icprog/FaboolCo2Pcba/README.md

# Fabool Laser CO2 PCBA
- Product page: https://www.smartdiys.cc/fabool-laser-co2/
- Shop page: https://shop.smartdiys.cc/collections/co2-laser-cutter-and-engraver
- Manual page: https://www.smartdiys.cc/manual/fabool-laser-co2-2/
