icprog/FaboolCo2Pcba/LaserCo2Board BOM_20170105.xlsx

Part / Value | Package | Manufacturer | Part No | Circuit Reference | Qty | URL
LD1117 | SOT-223 | STMicroelectronics | LD1117S33TR | U4 | 1 | http://www.digikey.jp/product-detail/ja/stmicroelectronics/LD1117S33TR/497-1242-2-ND/585766
74HC08A | TSSOP-14 | ON Semiconductor | MC74HC08ADTR2G | U5 | 1 | http://www.digikey.jp/product-detail/ja/on-semiconductor/MC74HC08ADTR2G/MC74HC08ADTR2GOSTR-ND/919179
74HC1G00 | TSOP-5 | ON Semiconductor | MC74HC1G00DTT1G | U8 | 1 | http://www.digikey.jp/product-detail/ja/MC74HC1G00DTT1G/MC74HC1G00DTT1GOSCT-ND/1967104
A4982 | 24-TSSOP | Allegro MicroSystems, LLC | A4982SLPTR | U3,U2 | 2 | http://www.digikey.jp/product-detail/ja/allegro-microsystems-llc/A4982SLPTR-T/620-1352-2-ND/2295512
MCP4461 | 20-TSSOP | Microchip Technology | MCP4461-103E/ST | U7 | 1 | http://www.digikey.jp/product-detail/ja/microchip-technology/MCP4461-103E%2FST/MCP4461-103E%2FST-ND/2486262
MCP4725 | SOT-23-6 | Microchip Technology | MCP4725A0T-E/CH | U6 | 1 | http://www.digikey.jp/product-detail/ja/microchip-technology/MCP4725A0T-E-CH/MCP4725A0T-E-CHTR-ND/1818537
STM32F205 | 64-LQFP | STMicroelectronics | STM32F205RBT6 | U1 | 1 | http://www.digikey.jp/product-search/ja?keywords=STM32F205RBT6
BSH105,215 | SOT-23 | NXP Semiconductors | BSH105 | TR1 | 1 | http://www.digikey.jp/product-detail/ja/nxp-semiconductors/BSH105,215/568-6215-2-ND/1155056
BSS138 | SOT-23 | Fairchild Semiconductor | BSS138 | Q1,Q2 | 2 | http://www.digikey.jp/product-detail/ja/fairchild-semiconductor/BSS138/BSS138CT-ND/244294
Tact Switch | DHT-1163S | D.O Electronics Co.,Ltd | DHT-1163S | SW1 | 1 | http://www.seeedstudio.com/depot/images/opl/datasheet/311020029.pdf
DIP Switch | MS-22D18 | DG De Yi Long Electronics Hardware Limited | MS-22D18 G2 | SW2 | 1 | http://www.seeedstudio.com/depot/images/opl/datasheet/3010010P1.pdf
ESD
VARISTOR 0603 | 0603 | Bourns Inc. | CG0603MLC-05E | VR1,VR2 | 2 | http://www.digikey.jp/product-detail/ja/bourns-inc/CG0603MLC-05E/CG0603MLC-05ETR-ND/2538084
Ferrite bead
220Ω@100MHz, 700mA | 0603 | Laird-Signal Integrity Products | LI0603G221R-10 | L1 | 1 | http://www.digikey.jp/product-detail/ja/LI0603G221R-10/240-2368-1-ND/806728
220Ω@100MHz, 2A | 0805 | Murata Electronics North America | BLM21PG221SN1D | L2 | 1 | http://www.digikey.jp/product-detail/ja/murata-electronics-north-america/BLM21PG221SN1D/490-1054-2-ND/364909
30Ω@100MHz, 8.5A | 0805 | Murata Electronics North America | BLM21SN300SN1D | L3,L4 | 2 | http://www.digikey.jp/product-detail/ja/murata-electronics-north-america/BLM21SN300SN1D/490-13266-6-ND/5881281
Crystal
25MHz, 18pF | 5032 | TXC CORPORATION | 7B-25.000MAAJ-T | X1 | 1 | http://www.digikey.jp/product-detail/ja/txc-corporation/7B-25.000MAAJ-T/887-1112-2-ND/2118796
RTC Crystal
32.768KHz, 7pF | 2-SMD | TXC CORPORATION | 9HT10-32.768KDZY-T | X2 | 1 | http://www.digikey.jp/product-detail/ja/txc-corporation/9HT10-32.768KDZY-T/887-1506-2-ND/2690359
LED
2V, 3mA, Red | 0805 | Any | Any | D1,D2,D3,D4,D5,D8 | 6
2V, 3mA, Green | 0805 | Any | Any | D7 | 1
2V, 3mA, Blue | 0805 | Any | Any | D6 | 1
Ceramic Capacitor
10p, Ceramic, 10V, 10% | 0603 | Any | Any | C24,C30 | 2
20p, Ceramic, 10V, 10% | 0603 | Any | Any | C19,C22 | 2
0u1, Ceramic, 10V, 10% | 0603 | Any | Any | C11,C12,C13,C14,C17,C18,C20,C21,C26,C27,C28,C29,C31,C33,C36,C38,C40 | 17
0u22, Ceramic, 10, 10% | 0603 | Any | Any | C1,C2,C9,C10 | 4
2u2, Ceramic, 10V, 10% | 0603 | Any | Any | C15,C16 | 2
1u, Ceramic, 10V, 10% | 0603 | Any | Any | C35 | 1
0u1, Ceramic, 16V, 10% | 0805 | Any | Any | C3,C4,C7,C8,C23 | 5
10u, Ceramic, 10V, 10% | 0805 | Any | Any | C32,C34,C37 | 3
Tantalum Capacitor
10uF, 10V, 20% | 1206 | Any | Any | C25 | 1
Aluminum Capacitor
100u, 35V, 20% | 6.3 x 7.7mm | Any | Any | C5,C6,C39 | 3 | http://www.digikey.jp/product-detail/ja/UWT1V101MCL1GS/493-2203-1-ND/590178
Resistor
0R, 1/10W | 0603 | Any | Any | R6,R7 | 2
22R, 1/10W, 5% | 0603 | Any | Any | R27, R39,R40 | 3
47R, 1/10W, 5% | 0603 | Any | Any | R34 | 1
100R, 1/10W, 5% | 0603 | Any | Any | R41 | 1
390R, 1/10W, 5% | 0603 | Any | Any | R36 | 1
470R, 1/10W, 5% | 0603 | Any | Any | R16,R17,R18,R25,R26,R45 | 6
1k5, 1/10W, 5% | 0603 | Any | Any | R44 | 1
2k7, 1/10W, 5% | 0603 | Any | Any | R32 | 1
4k7, 1/10W, 5% | 0603 | Any | Any | R28,R31,R43 | 3
10k, 1/10W, 5% | 0603 | Any | Any | R1,R3,R5,R12,R13,R14,R15,R19,R20,R21,R22,R23,R24,R29,R30,R37,R38,R42 | 18
100k, 1/10W, 5% | 0603 | Any | Any | R2,R4 | 2
0R1, 1W, 5% | 1206 | Any | Any | R8,R9,R10,R11 | 4
1k5, 1/2W, 5% | 1206 | Any | Any | R35 | 1
Connector
USB Type B Connector | USB - B | Any | Any | J4 | 1 | http://www.digikey.jp/product-detail/ja/on-shore-technology-inc/USB-B1HSW6/ED2982-ND/2677743
2P Connector |  | JST Sales America Inc | B2B-XH-A(LF)(SN) | J5,J6,J7,J8,J9,J15,J16,J17,J18,J19,J20 | 11
3P Connector |  | JST Sales America Inc | B3B-XH-A(LF)(SN) | J10,J13 | 2
4P Connector |  | JST Sales America Inc | B4B-XH-A(LF)(SN) | J11,J12,J14 | 3
Other
Heat Sink |  | Shenzhen S-mart Electronics Co.,Ltd | Heatsink 8.8*8.8*5mm with 3m thermal conductivity double-sided tape |  | 2
