icprog/FaboolCo2Pcba/LaserCo2Board/LaserCo2Board.pdf

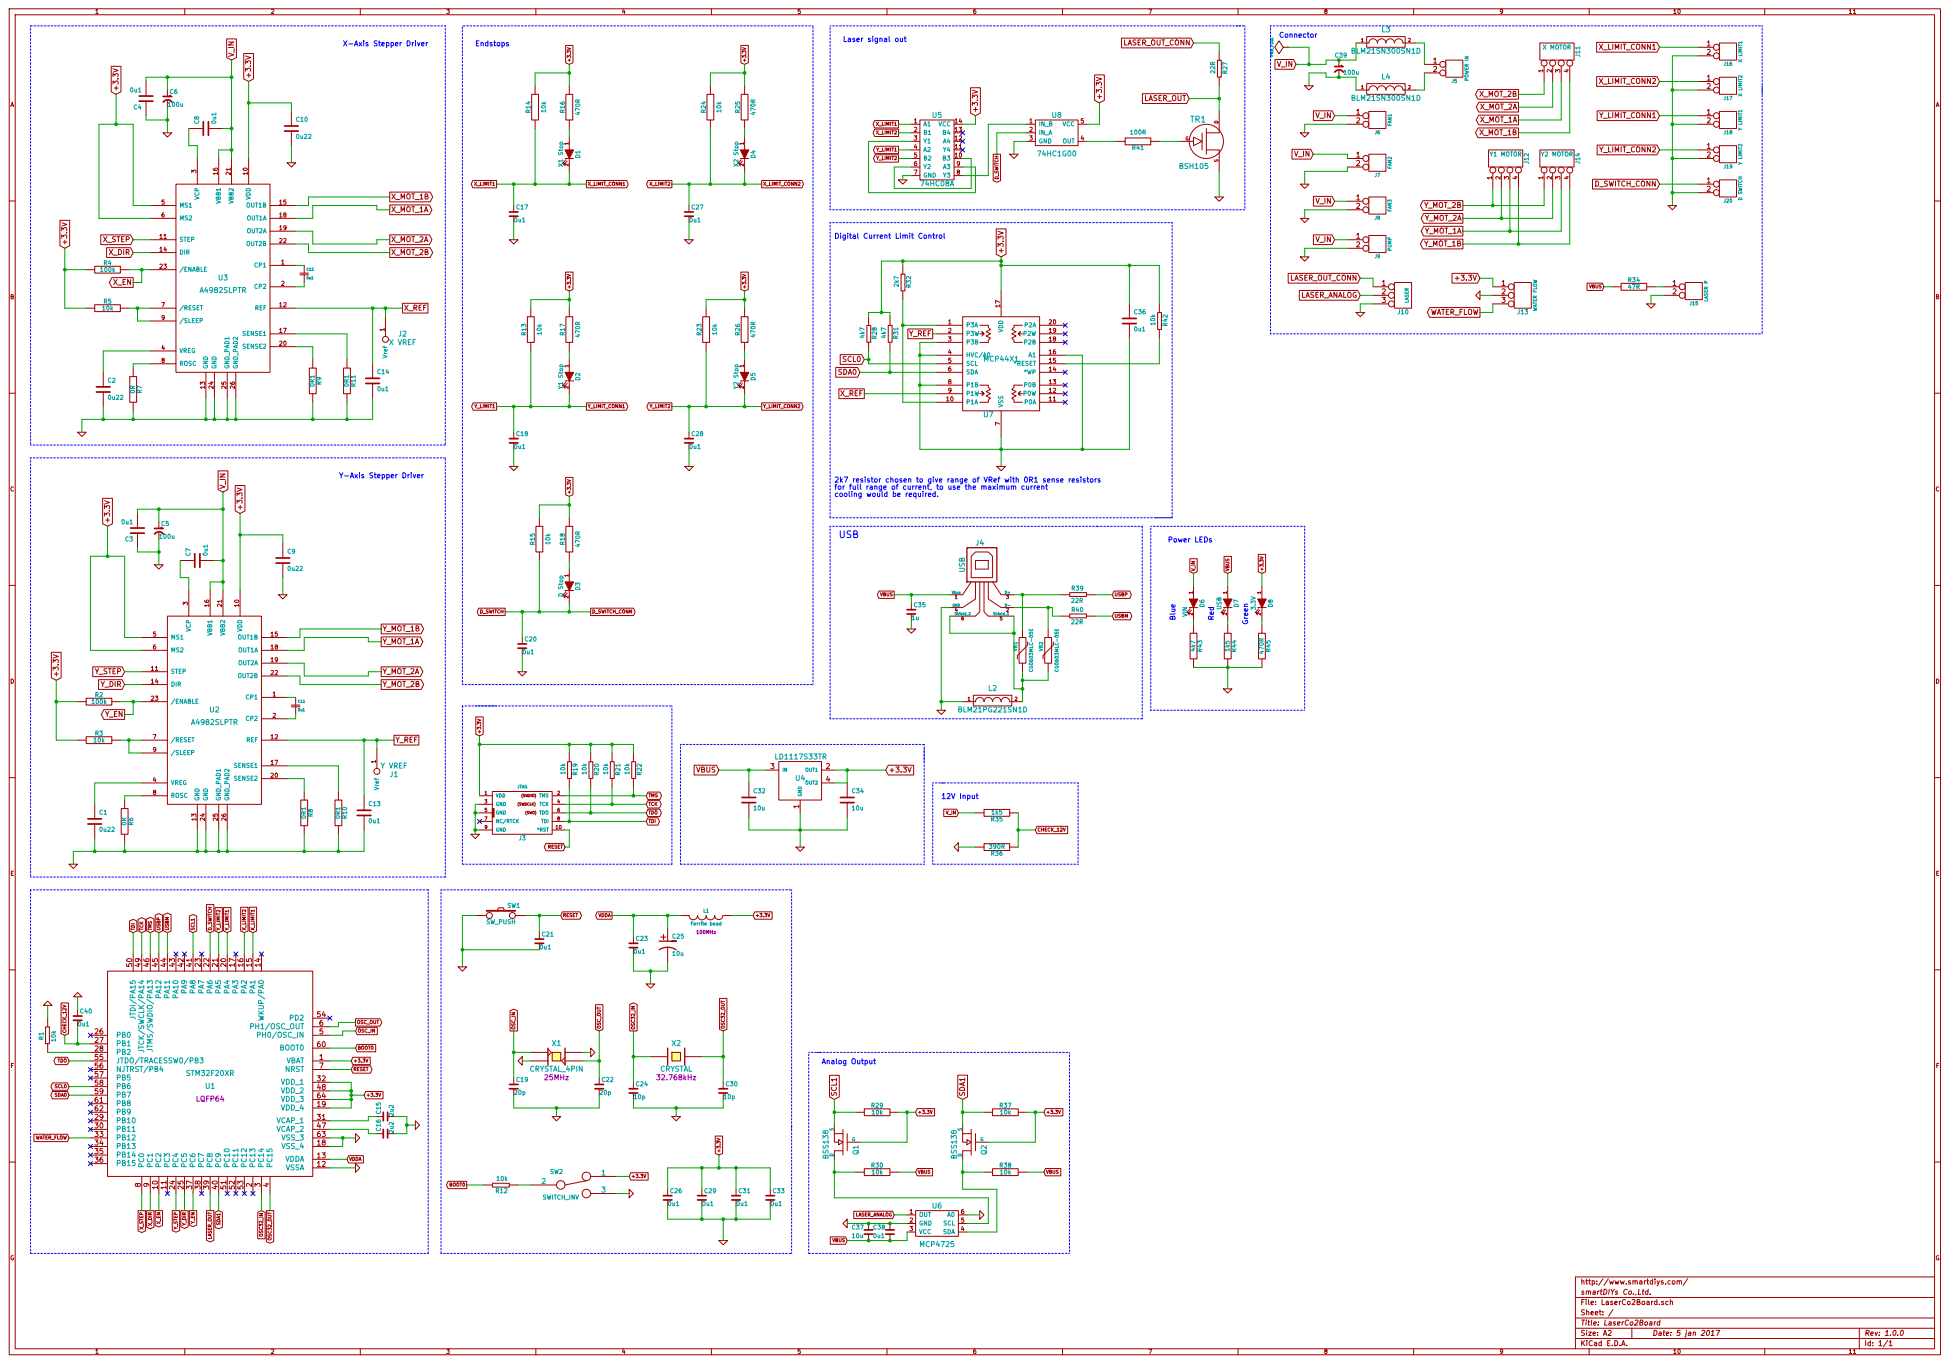
[picture p1: page 1]

Digital Current Limit Control

for full range of current, to use the maximum current

1 2 D6 VIN Power LEDs V_IN +3.3V Blue Green

USBP USBM TCK TMS USBP USBM
