icprog/FaboolCo2Pcba/LaserCo2Board/LaserCo2Board.kicad_pcb

## KiCad design LaserCo2Board/LaserCo2Board.kicad_pcb (2018-01-18)

Schematic: LaserCo2Board.sch

Parts:
C1, C2, C9, C10: 0u22
C3, C4, C7, C8, C11, C12, C13, C14, C17, C18, C20, C21, C23, C26, C27, C28, C29, C31, C33, C36, C38, C40: 0u1
C5, C6, C39: 100u
C15, C16: 2u2
C19, C22: 20p
C24, C30: 10p
C25: 10u
C32, C34, C37: 10u
C35: 1u
D1: X1 Stop
D2: Y1 Stop
D3: D Stop
D4: X2 Stop
D5: Y2 Stop
D6: VIN
D7: USB
D8: 3.3V
J1: Y VREF
J2: X VREF
J3: JTAG
J4: USB
J5: POWER IN
J6: FAN1
J7: FAN2
J8: FAN3
J9: PUMP
J10: LASER
J11: X MOTOR
J12: Y1 MOTOR
J13: WATER FLOW
J14: Y2 MOTOR
J15: LASER P
J16: X LIMIT1
J17: X LIMIT2
J18: Y LIMIT1
J19: Y LIMIT2
J20: D SWITCH
L1: Ferrite bead
L2: BLM21PG221SN1D
L3, L4: BLM21SN300SN1D
Q1, Q2: BSS138
R1, R3, R5, R12, R13, R14, R15, R19, R20, R21, R22, R23, R24, R29, R30, R37, R38, R42: 10k
R2: 100k; 0603
R4: 100k
R6, R7: 0R
R8, R9, R10, R11: 0R1
R16, R17, R18, R25, R26, R45: 470R
R27, R39, R40: 22R
R28, R31, R43: 4k7
R32: 2k7
R34: 47R
R35, R44: 1k5
R36: 390R
R41: 100R
SW1: SW_PUSH
SW2: SWITCH_INV
TR1: BSH105
U1: STM32F20XR; LQFP64
U2: A4982SLPTR
U3: A4982SLPTR
U4: LD1117S33TR
U5: 74HC08A
U6: MCP4725
U7: MCP44X1
U8: 74HC1G00
VR1, VR2: CG0603MLC-05E
X1: CRYSTAL_4PIN
X2: CRYSTAL

Connections:
+3.3V: C9.1, C10.1, C26.1, C29.1, C31.1, C33.1, C34.1, C36.1, D8.1 (A), J3.1 (VDD), J13.1, L1.1, Q1.G, Q2.G, R2.1, R3.1, R4.1, R5.1, R13.2, R14.2, R15.2, R16.2, R17.2, R18.2, R19.1, R20.1, R21.1, R22.1, R23.2, R24.2, R25.2, R26.2, R28.1, R29.2, R31.1, R32.1, R37.2, R42.1, SW2.1, U1.1 (VBAT), U1.19 (VDD_4), U1.32 (VDD_1), U1.48 (VDD_2), U1.64 (VDD_3), U2.5 (MS1), U2.6 (MS2), U2.10 (VDD), U3.5 (MS1), U3.6 (MS2), U3.10 (VDD), U4.2 (OUT1), U4.4 (OUT2), U5.14 (VCC), U7.17 (VDD), U8.5 (VCC)
BOOT0: R12.2, U1.60 (BOOT0)
CHECK_12V: C40.2, R35.1, R36.1, U1.27 (PB1)
D_SWITCH: C20.1, D3.2 (K), J20.1, R15.1, U1.22 (PA6), U8.2 (IN_A)
GND: C1.2, C2.2, C3.1, C4.1, C5.2, C6.2, C9.2, C10.2, C13.2, C14.2, C15.2, C16.2, C17.2, C18.2, C19.2, C20.2, C21.2, C22.2, C23.2, C24.2, C25.2, C26.2, C27.2, C28.2, C29.2, C30.2, C31.2, C32.2, C33.2, C34.2, C35.2, C36.2, C37.1, C38.1, C39.2, C40.1, J3.3 (GND), J3.5 (GND), J3.9 (GND), J4.4 (GND), J6.2 (PM), J7.2 (PM), J8.2 (PM), J9.2 (PM), J10.3, J13.2 (PM), J15.2 (PM), J16.2 (PM), J17.2 (PM), J18.2 (PM), J19.2 (PM), J20.2 (PM), L2.1, L4.1, R1.2, R6.2, R7.2, R8.2, R9.2, R10.2, R11.2, R36.2, R43.2, R44.2, R45.2, SW1.1, SW2.3, TR1.S, U1.12 (VSSA), U1.18 (VSS_4), U1.63 (VSS_3), U2.13 (GND), U2.24 (GND), U2.25 (GND_PAD1), U2.26 (GND_PAD2), U3.13 (GND), U3.24 (GND), U3.25 (GND_PAD1), U3.26 (GND_PAD2), U4.1 (GND), U5.7 (GND), U6.2 (GND), U6.6 (A0), U7.3 (P3B), U7.4 (HVC/A0), U7.7 (VSS), U7.8 (P1B), U7.16 (A1), U8.3 (GND), X1.2, X1.4
LASER_ANALOG: J10.2 (PM), U6.1 (OUT)
LASER_OUT: R27.2, TR1.D, U1.39 (PC8)
LASER_OUT_CONN: J10.1, R27.1
unnamed: D2.1 (A), R17.1
unnamed: D1.1 (A), R16.1
unnamed: R42.2, U7.15 (*RESET)
unnamed: R32.2, U7.1 (P3A), U7.10 (P1A)
unnamed: C1.1, U2.4 (VREG)
unnamed: C7.1, U2.3 (VCP)
unnamed: R3.2, U2.7 (/RESET), U2.9 (/SLEEP)
unnamed: R6.1, U2.8 (ROSC)
unnamed: R10.1, U2.17 (SENSE1)
unnamed: R8.1, U2.20 (SENSE2)
unnamed: D3.1 (A), R18.1
unnamed: R41.1, TR1.G
unnamed: R41.2, U8.4 (OUT)
unnamed: C12.2, U3.2 (CP2)
unnamed: C12.1, U3.1 (CP1)
unnamed: C11.2, U2.2 (CP2)
unnamed: C11.1, U2.1 (CP1)
unnamed: D6.2 (K), R43.1
unnamed: D8.2 (K), R45.1
unnamed: J5.2 (PM), L4.2
unnamed: J5.1, L3.2
unnamed: R5.2, U3.7 (/RESET), U3.9 (/SLEEP)
unnamed: R9.1, U3.20 (SENSE2)
unnamed: R11.1, U3.17 (SENSE1)
unnamed: C2.1, U3.4 (VREG)
unnamed: R7.1, U3.8 (ROSC)
unnamed: C8.1, U3.3 (VCP)
unnamed: U5.3 (Y1), U5.9 (A3)
unnamed: U5.6 (Y2), U5.10 (B3)
unnamed: J4.5 (Shield_1), J4.6 (Shield_2), L2.2, VR1.1, VR2.1
unnamed: D4.1 (A), R25.1
unnamed: D5.1 (A), R26.1
unnamed: J15.1, R34.2
unnamed: Q1.D, R30.1, U6.5 (SCL)
unnamed: Q2.D, R38.1, U6.4 (SDA)
unnamed: J4.2 (D-), R40.1, VR2.2
unnamed: C16.1, U1.47 (VCAP_2)
unnamed: C15.1, U1.31 (VCAP_1)
unnamed: D7.2 (K), R44.1
unnamed: J4.3 (D+), R39.1, VR1.2
unnamed: R12.1, SW2.2
unnamed: R1.1, U1.28 (PB2)
unnamed: U5.8 (Y3), U8.1 (IN_B)
OSC32_IN: C24.1, U1.3 (PC14), X2.1
OSC32_OUT: C30.1, U1.4 (PC15), X2.2
OSC_IN: C19.1, U1.5 (PH0/OSC_IN), X1.1
OSC_OUT: C22.1, U1.6 (PH1/OSC_OUT), X1.3
RESET: C21.1, J3.10 (*RST), SW1.2, U1.7 (NRST)
SCL0: R28.2, U1.58 (PB6), U7.5 (SCL)
SCL1: Q1.S, R29.1, U1.41 (PA8)
SDA0: R31.2, U1.59 (PB7), U7.6 (SDA)
SDA1: Q2.S, R37.1, U1.40 (PC9)
TCK: J3.4 (TCK), R21.2, U1.49 (JTCK/SWCLK/PA14)
TDI: J3.8 (TDI), R19.2, U1.50 (JTDI/PA15)
TDO: J3.6 (TDO), R20.2, U1.55 (JTDO/TRACESSW0/PB3)
TMS: J3.2 (TMS), R22.2, U1.46 (JTMS/SWDIO/PA13)
USBM: R40.2, U1.44 (PA11)
USBP: R39.2, U1.45 (PA12)
VBUS: C32.1, C35.1, C37.2, C38.2, D7.1 (A), J4.1 (Vbus), R30.2, R34.1, R38.2, U4.3 (IN), U6.3 (VCC)
VDDA: C23.1, C25.1, L1.2, U1.13 (VDDA)
V_IN: C3.2, C4.2, C5.1, C6.1, C7.2, C8.2, C39.1, D6.1 (A), J6.1, J7.1, J8.1, J9.1, L3.1, R35.2, U2.16 (VBB1), U2.21 (VBB2), U3.16 (VBB1), U3.21 (VBB2)
WATER_FLOW: J13.3, U1.33 (PB12)
X_DIR: U1.9 (PC1), U3.14 (DIR)
X_EN: R4.2, U1.10 (PC2), U3.23 (/ENABLE)
X_LIMIT1: C17.1, D1.2 (K), J16.1, R14.1, U1.15 (PA1), U5.1 (A1)
X_LIMIT2: C27.1, D4.2 (K), J17.1, R24.1, U1.16 (PA2), U5.2 (B1)
X_MOT_1A: J11.3, U3.18 (OUT1A)
X_MOT_1B: J11.4, U3.15 (OUT1B)
X_MOT_2A: J11.2, U3.19 (OUT2A)
X_MOT_2B: J11.1, U3.22 (OUT2B)
X_REF: C14.1, J2.1, U3.12 (REF), U7.9 (P1W)
X_STEP: U1.8 (PC0), U3.11 (STEP)
Y_DIR: U1.25 (PC5), U2.14 (DIR)
Y_EN: R2.2, U1.37 (PC6), U2.23 (/ENABLE)
Y_LIMIT1: C18.1, D2.2 (K), J18.1, R13.1, U1.20 (PA4), U5.4 (A2)
Y_LIMIT2: C28.1, D5.2 (K), J19.1, R23.1, U1.21 (PA5), U5.5 (B2)
Y_MOT_1A: J12.3, J14.3, U2.18 (OUT1A)
Y_MOT_1B: J12.4, J14.4, U2.15 (OUT1B)
Y_MOT_2A: J12.2, J14.2, U2.19 (OUT2A)
Y_MOT_2B: J12.1, J14.1, U2.22 (OUT2B)
Y_REF: C13.1, J1.1, U2.12 (REF), U7.2 (P3W)
Y_STEP: U1.24 (PC4), U2.11 (STEP)

Notes on the sheet:
Power LEDs
Blue
Green
2k7 resistor chosen to give range of VRef with 0R1 sense resistors for full range of current, to use the maximum current cooling would be required.
Endstops
Digital Current Limit Control
Y-Axis Stepper Driver
X-Axis Stepper Driver
USB
Laser signal out
Connector
Red
Analog Output
12V Input

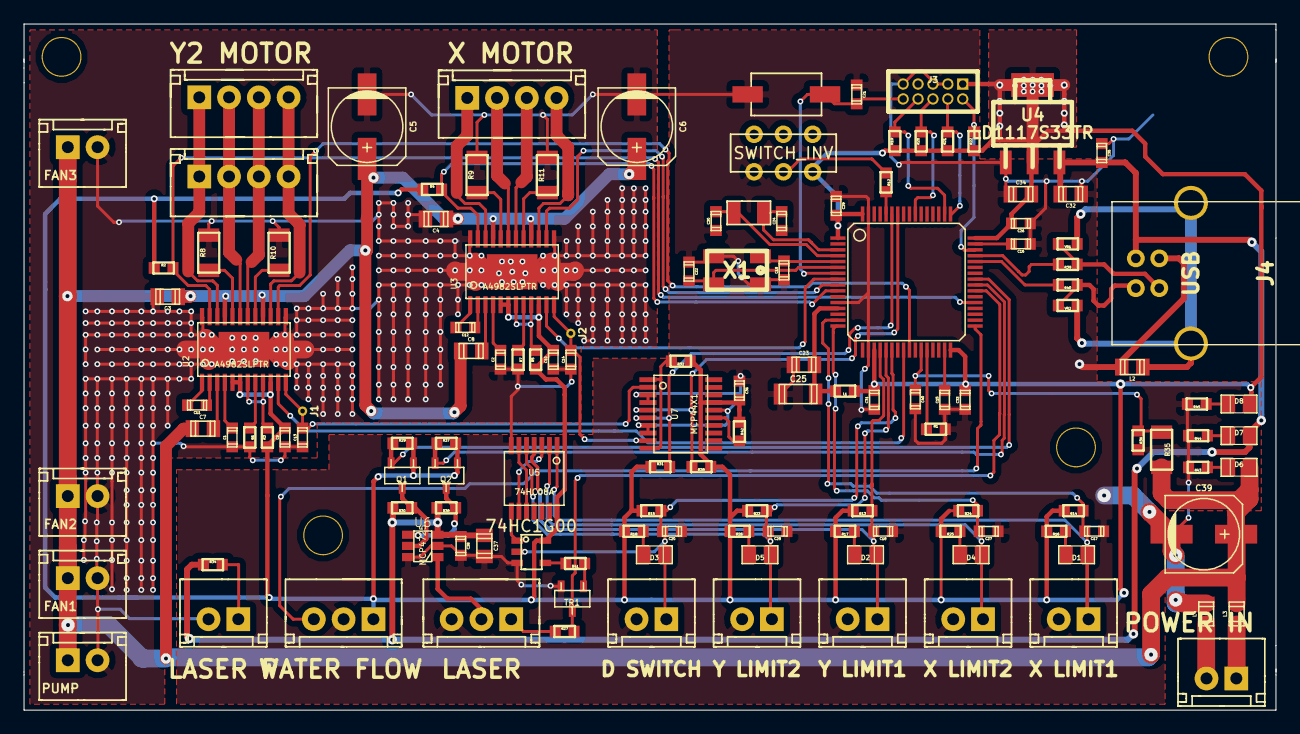
[picture p2: board LaserCo2Board.kicad_pcb from above]

Board: 2 copper layers, 106.8 x 58.5 mm, 133 parts (0 on the bottom side), 90 nets.
