icprog/FaboolCo2Pcba/(commit log)

2016-09-27 サンプル確認後の修正
    #16
    #15
    #14
    #13
    #12
    [LaserCo2Board BOM.xlsx, LaserCo2Board.kicad_pcb, LaserCo2Board.sch]
2016-09-27 ガーバーデーター更新
    [LaserCo2Board BOM.xlsx]
2016-10-05 シルク文字修正
    [LaserCo2Board.kicad_pcb]
2016-10-17 BOMにヒートシンク追加
    [LaserCo2Board BOM.xlsx]
2017-01-05 ノイズ対策
    [LaserCo2Board BOM.xlsx, LaserCo2Board BOM_20170105.xlsx, LaserCo2Board.kicad_pcb, LaserCo2Board.sch]
2017-01-19 ノイズ対策2
    [LaserCo2Board BOM_20170105.xlsx, LaserCo2Board BOM_20170119.xlsx, LaserCo2Board.kicad_pcb, LaserCo2Board.sch]
2017-01-20 hot fix
    [LaserCo2Board BOM_20170119.xlsx]
2017-01-27 元に戻す
    [LaserCo2Board BOM_20170105.xlsx, LaserCo2Board BOM_20170119.xlsx, LaserCo2Board.kicad_pcb, LaserCo2Board.sch]
2017-09-13 穴位置を0.5移動
    [LaserCo2Board.kicad_pcb]
2018-01-18 ねじ穴周辺レジスト除去
    [LaserCo2Board.kicad_pcb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]
